kxt777/Development-of-a-12-DOF-Quadruped-Robot/docs/verification_20261030/vision_transport_fixture/rgb_latest.jpg

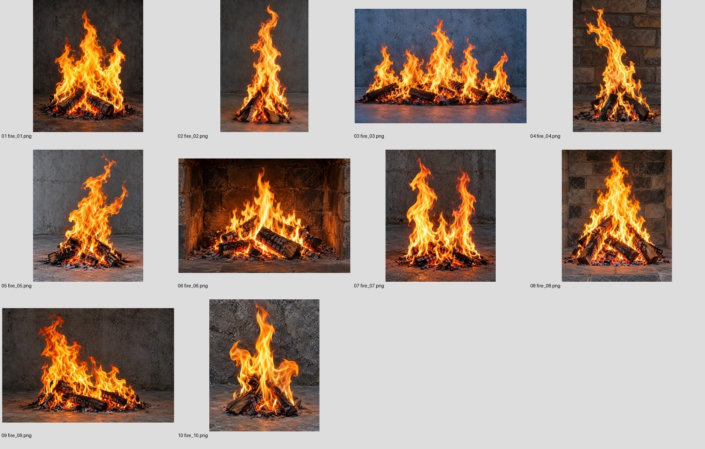
docs/verification_20261030/vision_transport_fixture/rgb_latest.jpg
