kxt777/Development-of-a-12-DOF-Quadruped-Robot/reference/README.md

# 追溯源码

这里保存旧独立启动脚本、训练与离线处理方法、原服务配置和第三方依赖源码。

- 日常运行使用 `../dog` 和统一 `dog_system.launch.py`。
- 旧脚本保留历史绝对路径；不要把它们作为第二套在线控制器并行启动。
- third_party 的许可证随源码保留。上游默认 launch 不参与本整理版日常启动。
- nuc_services 只是一份原配置副本，本次不会安装、启用或替换任何 systemd 服务。
