kxt777/Development-of-a-12-DOF-Quadruped-Robot/maps/fire_scene/edit_comparison.png

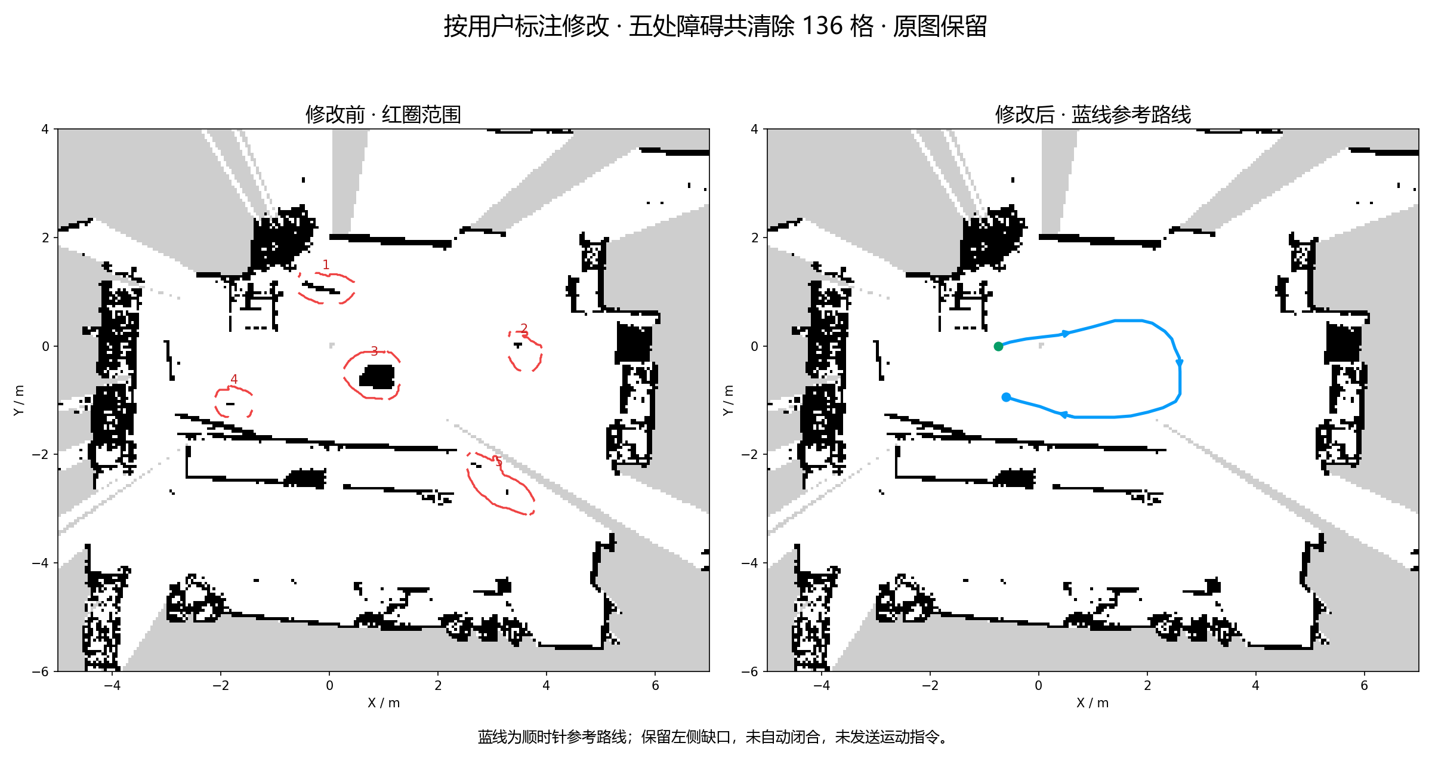
maps/fire_scene/edit_comparison.png
