kxt777/Development-of-a-12-DOF-Quadruped-Robot/maps/fire_scene/user_annotation.png

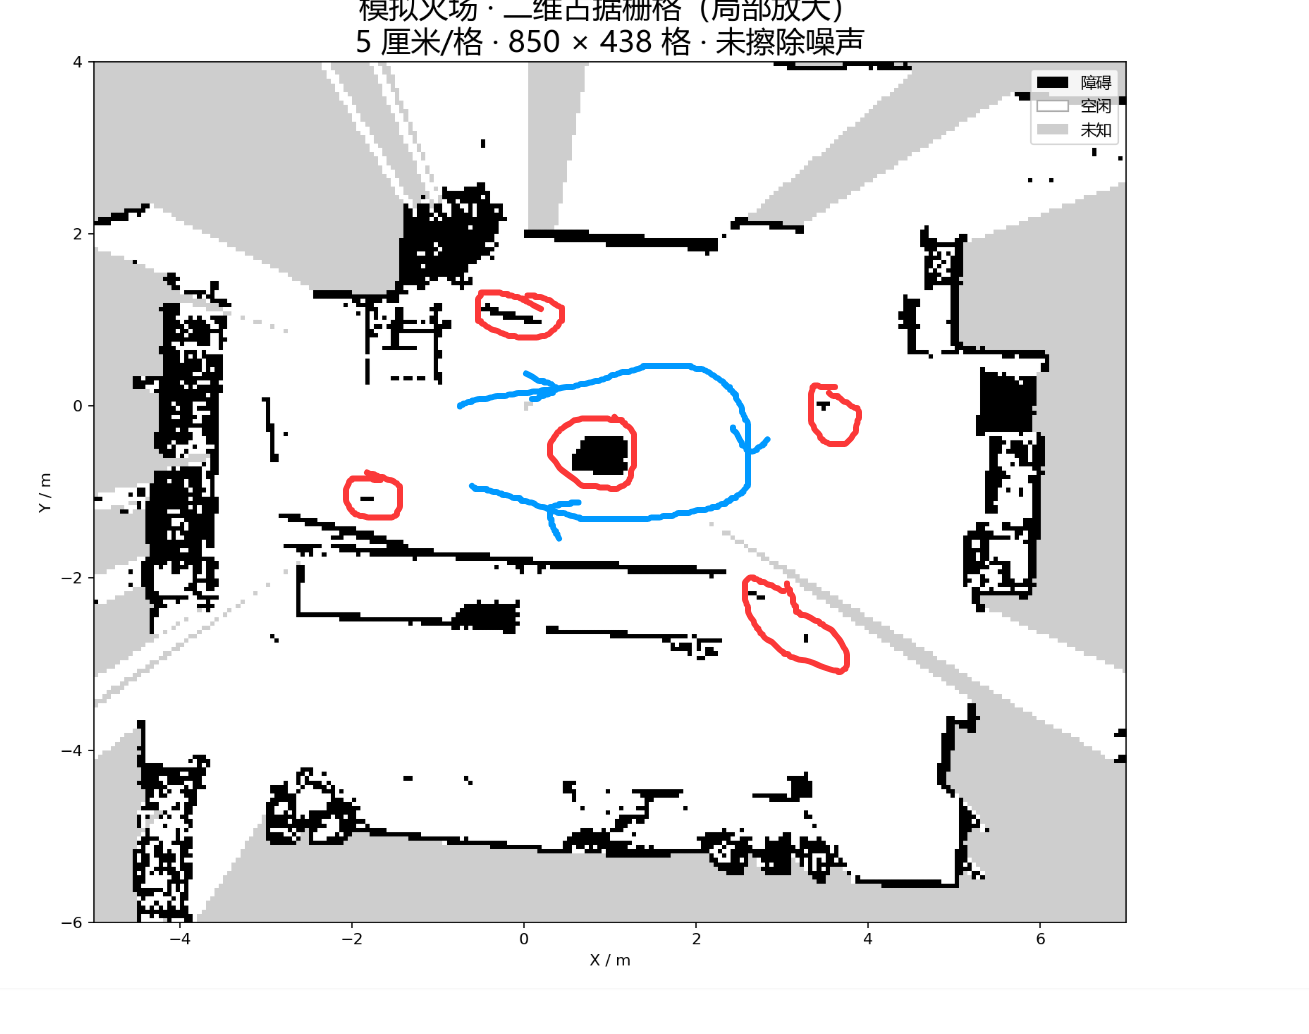
maps/fire_scene/user_annotation.png
