kxt777/Development-of-a-12-DOF-Quadruped-Robot/ros2_ws/src/dog_navigation/references/mid360s_page22.png

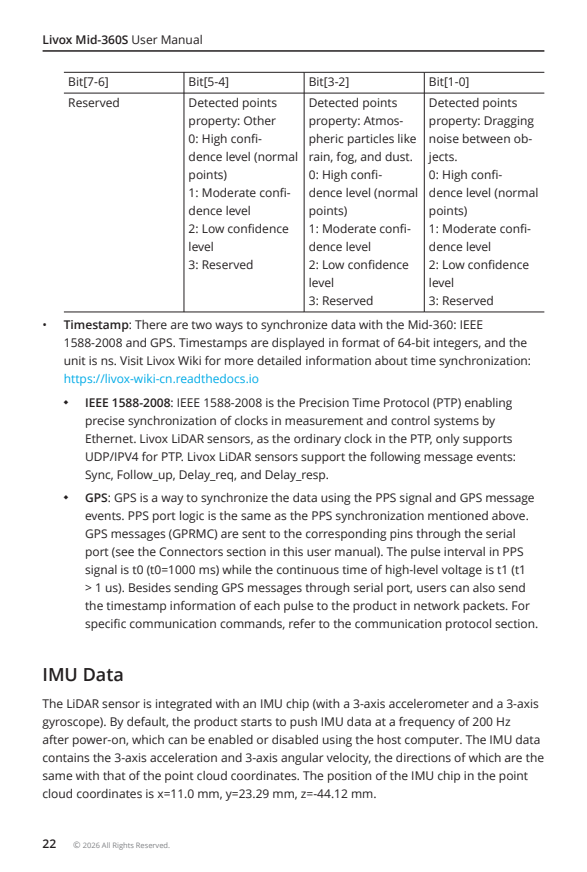
ros2_ws/src/dog_navigation/references/mid360s_page22.png
