kxt777/Development-of-a-12-DOF-Quadruped-Robot/ros2_ws/src/dog_description/meshes/Link_br_2.STL

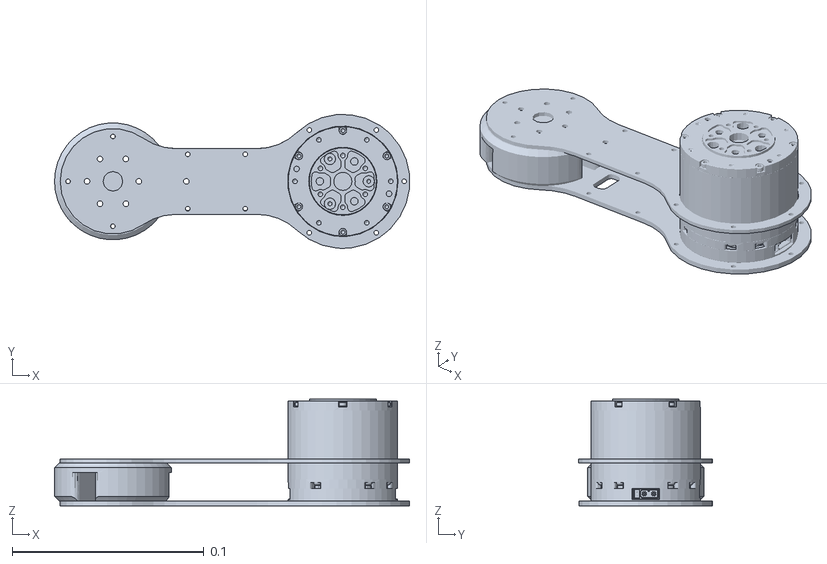
[picture p5: CAD file, 2026-11-04]
ros2_ws/src/dog_description/meshes/Link_br_2.STL
0.185 x 0.0698 x 0.0558
