kxt777/Development-of-a-12-DOF-Quadruped-Robot/ros2_ws/src/dog_description/meshes/Link_fl_2.STL

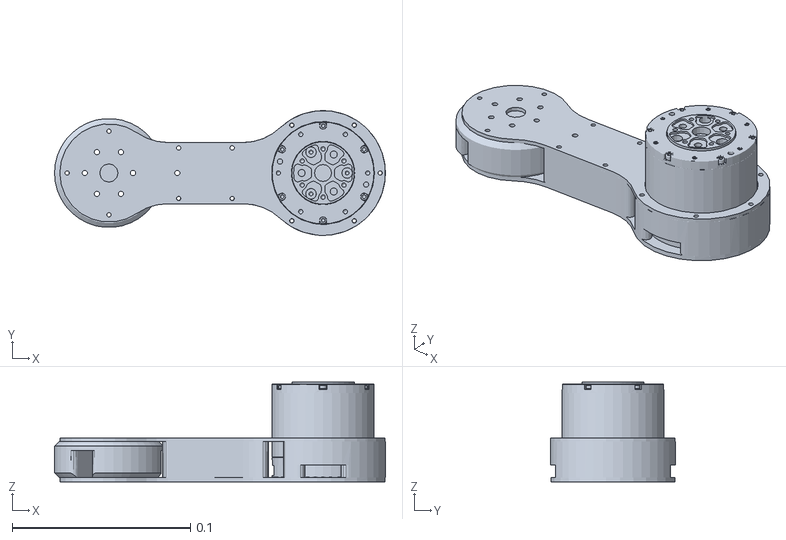
[picture p6: CAD file, 2026-11-04]
ros2_ws/src/dog_description/meshes/Link_fl_2.STL
0.186 x 0.07 x 0.0558
