kxt777/Development-of-a-12-DOF-Quadruped-Robot/ros2_ws/src/dog_description/meshes/Link_fl_1.STL

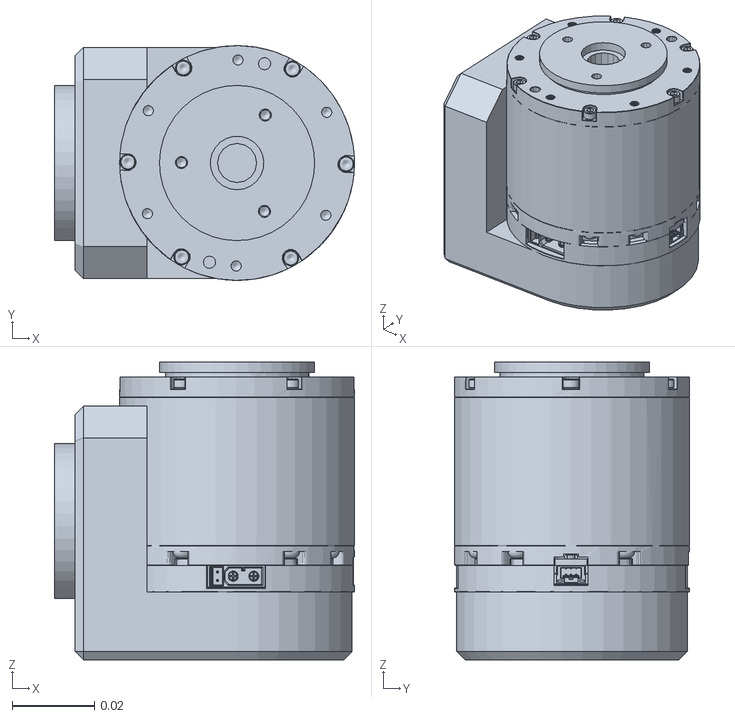
[picture p8: CAD file, 2026-11-04]
ros2_ws/src/dog_description/meshes/Link_fl_1.STL
0.0728 x 0.057 x 0.0722
