kxt777/Development-of-a-12-DOF-Quadruped-Robot/ros2_ws/src/dog_description/meshes/base_link.STL

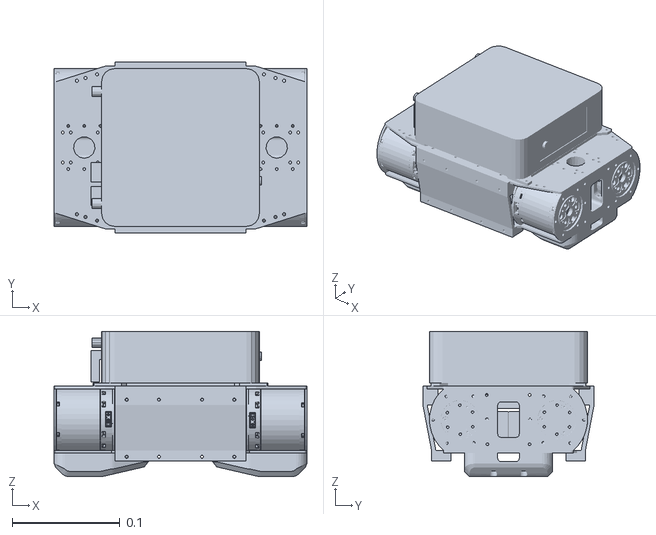
[picture p9: CAD file, 2026-11-04]
ros2_ws/src/dog_description/meshes/base_link.STL
0.235 x 0.159 x 0.135
