kxt777/Development-of-a-12-DOF-Quadruped-Robot/ros2_ws/src/dog_description/meshes/Link_bl_3.STL

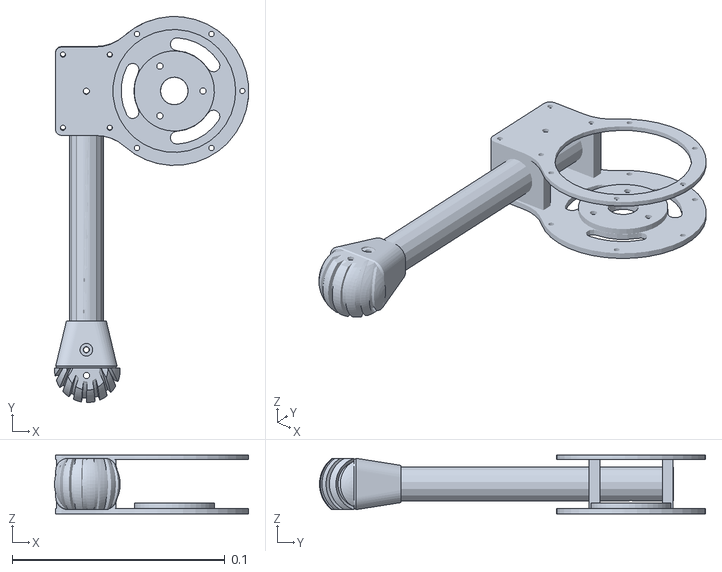
[picture p11: CAD file, 2026-11-04]
ros2_ws/src/dog_description/meshes/Link_bl_3.STL
0.0912 x 0.181 x 0.0275
