kxt777/Development-of-a-12-DOF-Quadruped-Robot/ros2_ws/src/dog_description/meshes/Link_br_3.STL

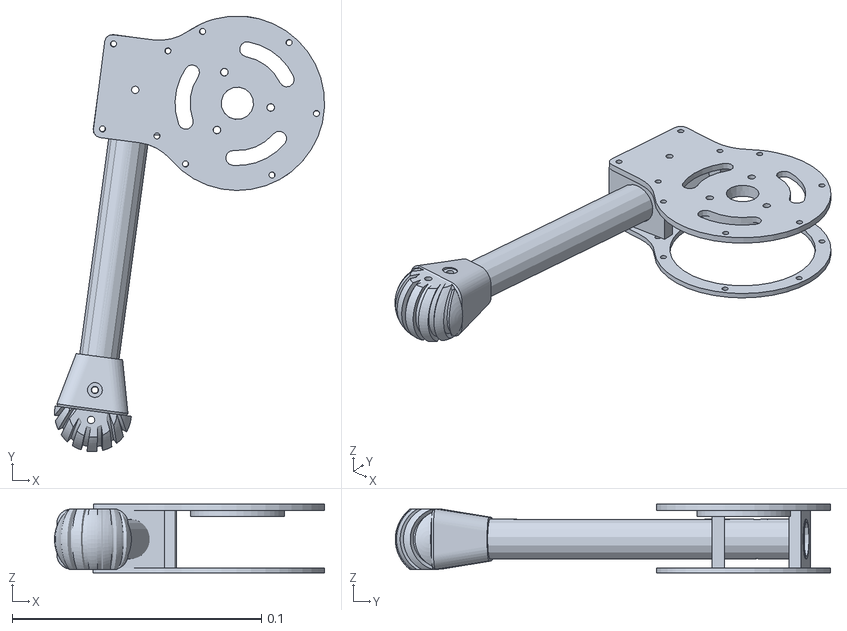
[picture p12: CAD file, 2026-11-04]
ros2_ws/src/dog_description/meshes/Link_br_3.STL
0.108 x 0.175 x 0.0275
