kxt777/Development-of-a-12-DOF-Quadruped-Robot/(list of files, cad)

Other CAD files:
ros2_ws/src/dog_description/meshes/Link_bl_2.STL
ros2_ws/src/dog_description/meshes/Link_fr_1.STL
ros2_ws/src/dog_description/meshes/Link_br_1.STL
ros2_ws/src/dog_description/meshes/Link_bl_1.STL
ros2_ws/src/dog_description/meshes/Link_fr_2.STL
