kxt777/Development-of-a-12-DOF-Quadruped-Robot/firmware/stm32h723/02_stm32h723_nuc_OK.ioc

Mcu.UserName=STM32H723VGTx
PA11.Signal=USB_OTG_HS_DM
PA12.Signal=USB_OTG_HS_DP
PH0-OSC_IN.Signal=RCC_OSC_IN
PH1-OSC_OUT.Signal=RCC_OSC_OUT
