kxt777/Development-of-a-12-DOF-Quadruped-Robot/firmware/stm32h723/Core/Inc/gpio.h

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
/* Define to prevent recursive inclusion -------------------------------------*/
#ifndef __GPIO_H__
#define __GPIO_H__

#ifdef __cplusplus
extern "C" {
#endif

/* Includes ------------------------------------------------------------------*/
#include "main.h"

/* USER CODE BEGIN Private defines */
#define Power_OUT1_ON  HAL_GPIO_WritePin(GPIOC, GPIO_PIN_13, GPIO_PIN_SET)
#define Power_OUT1_OFF HAL_GPIO_WritePin(GPIOC, GPIO_PIN_13, GPIO_PIN_RESET)
#define Power_OUT2_ON  HAL_GPIO_WritePin(GPIOC, GPIO_PIN_14, GPIO_PIN_SET)
#define Power_OUT2_OFF HAL_GPIO_WritePin(GPIOC, GPIO_PIN_14, GPIO_PIN_RESET)

/* USER CODE END Private defines */

void MX_GPIO_Init(void);

#ifdef __cplusplus
}
#endif
#endif /*__ GPIO_H__ */
