kxt777/Development-of-a-12-DOF-Quadruped-Robot/(notices)

Notices in the files:
firmware/stm32h723/Core/Src/main.c:
Copyright (c) 2026 STMicroelectronics.
All rights reserved.
This software is licensed under terms that can be found in the LICENSE file
